MarceloCampos/PROTON2-.NetMF-Board/README.md

# PROTON2 .Net MicroFramework Board
 PROTON2 STM32F401 .NetMF Board
 
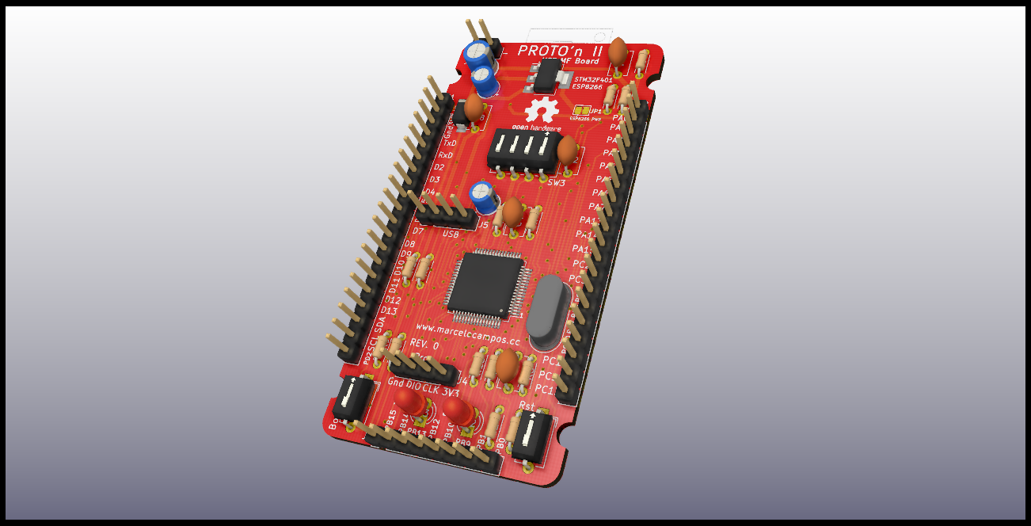
[picture p1: PROTON2_3D.png]
placa
