MarceloCampos/PROTON2-.NetMF-Board/Lista Materiais-BoardNETMF1.xlsx

 |  | PROTO’N II – Lista de Materiais |  | LOTE
 |  | Rev.0 – Mar/20 |  | 5
Qtd PCI | Qtd Lote | Descrição | Valor
5 | 25 | Capacitor Metal Film mini (amarelo) | 100 nF
1 | 5 | Cap. Eletrol. Mini x 16V | 4.7uF
1 | 5 | Cap. Eletrol. Mini x 16V | 100 uF
1 | 5 | Cap. Eletrol. Mini x 16V | 10 uF
1 | 5 | LM1117MPX_3.3 encapsulamento SOT-223
1 | 5 | Diodo SMD M7 encapsulamento DO-214AC/SMA | 1N4007 SMD
1 | 5 | Led 3mm leitoso | Vermelho
1 | 5 | Led 3mm leitoso | Verde
1 | 5 | Resistor CR12 1/8W – 5% | 680r
1 | 5 | Resistor CR12 1/8W – 5% | 1 K
3 | 15 | Resistor CR12 1/8W – 5% | 33 R
9 | 45 | Resistor CR12 1/8W – 5% | 10 K
2 | 10 | Micro chave | SW_Push
1 | 5 | Dip Switch 4 posições horizontal | SW_DIP_x04
1 | 5 | Cristal HC-49 | 8 MHz
1 | 5 | STM32F401RET6
