MarceloCampos/PROTON2-.NetMF-Board/PROTON2_sch.pdf

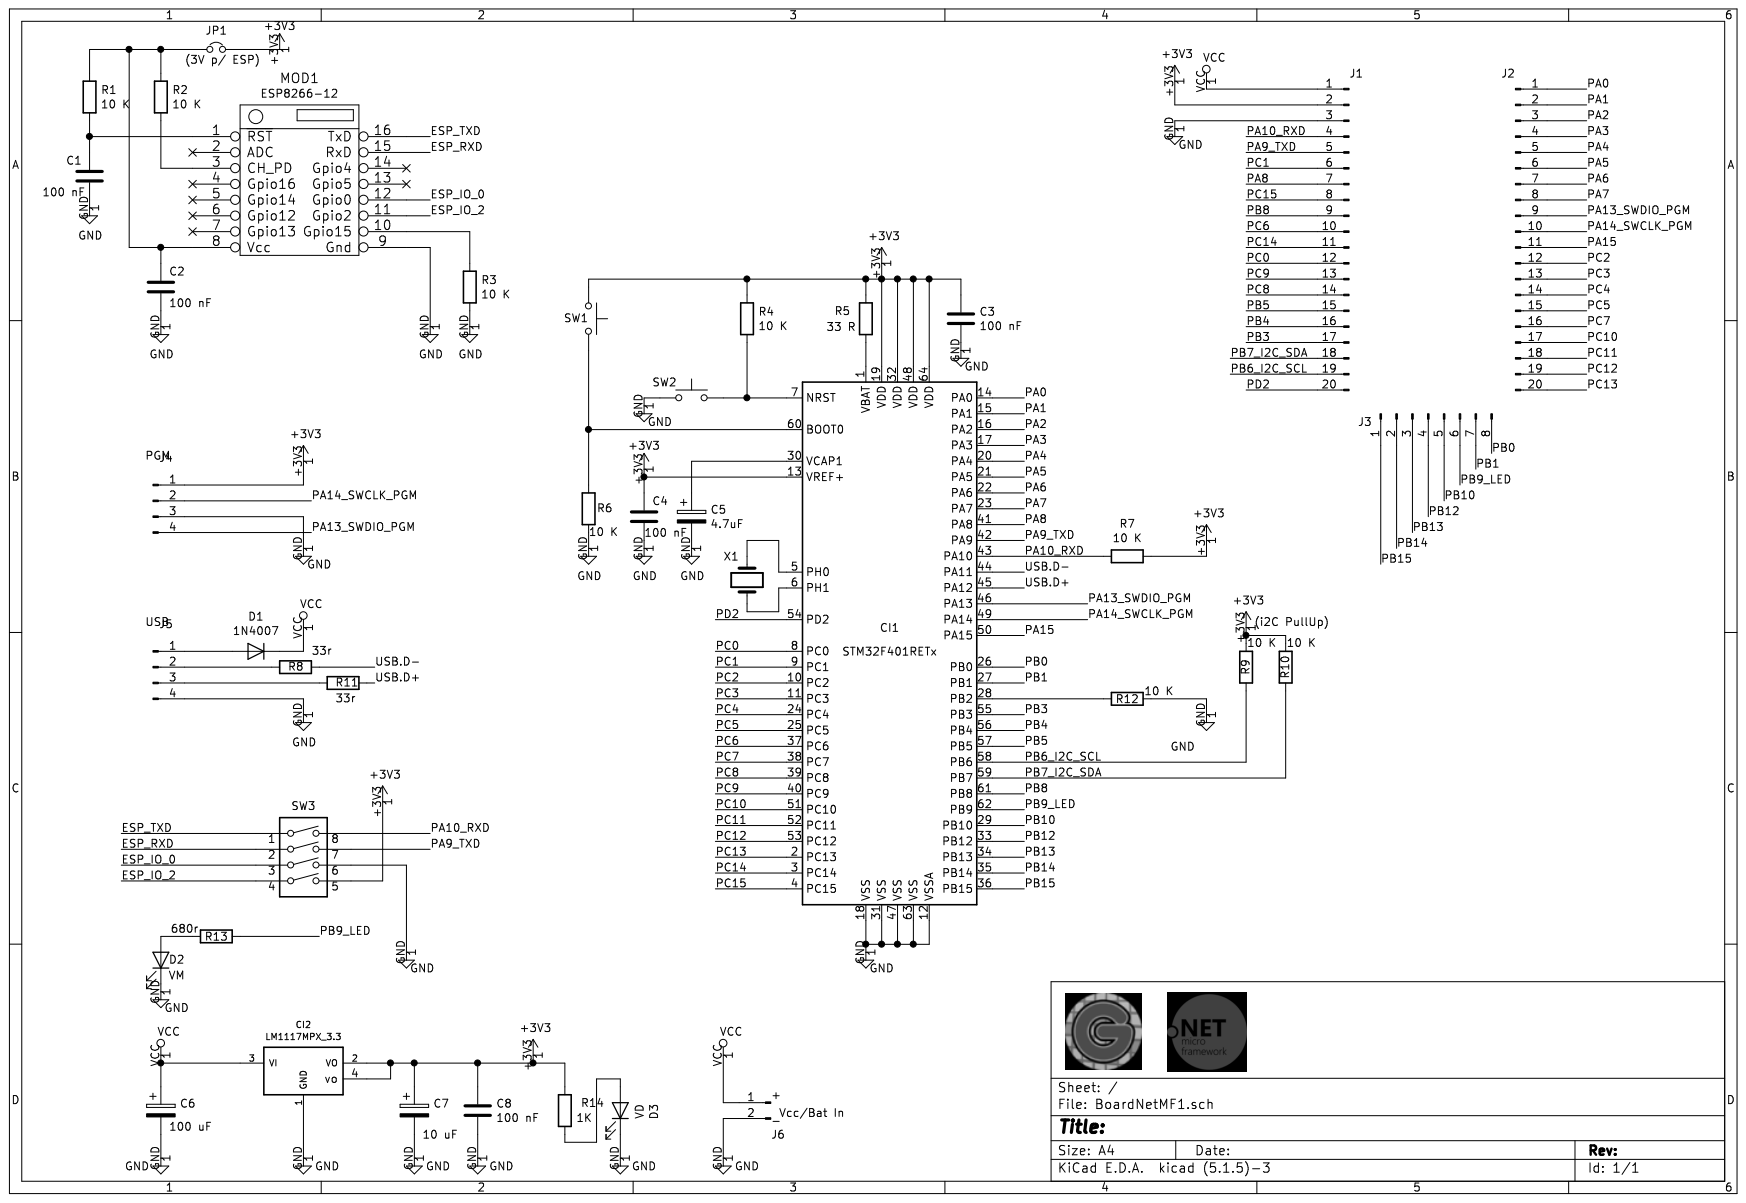
[picture p11: page 1]
