MarceloCampos/PROTON2-.NetMF-Board/BoardNetMF1.kicad_pcb

## KiCad design BoardNetMF1.kicad_pcb (2020-03-26)

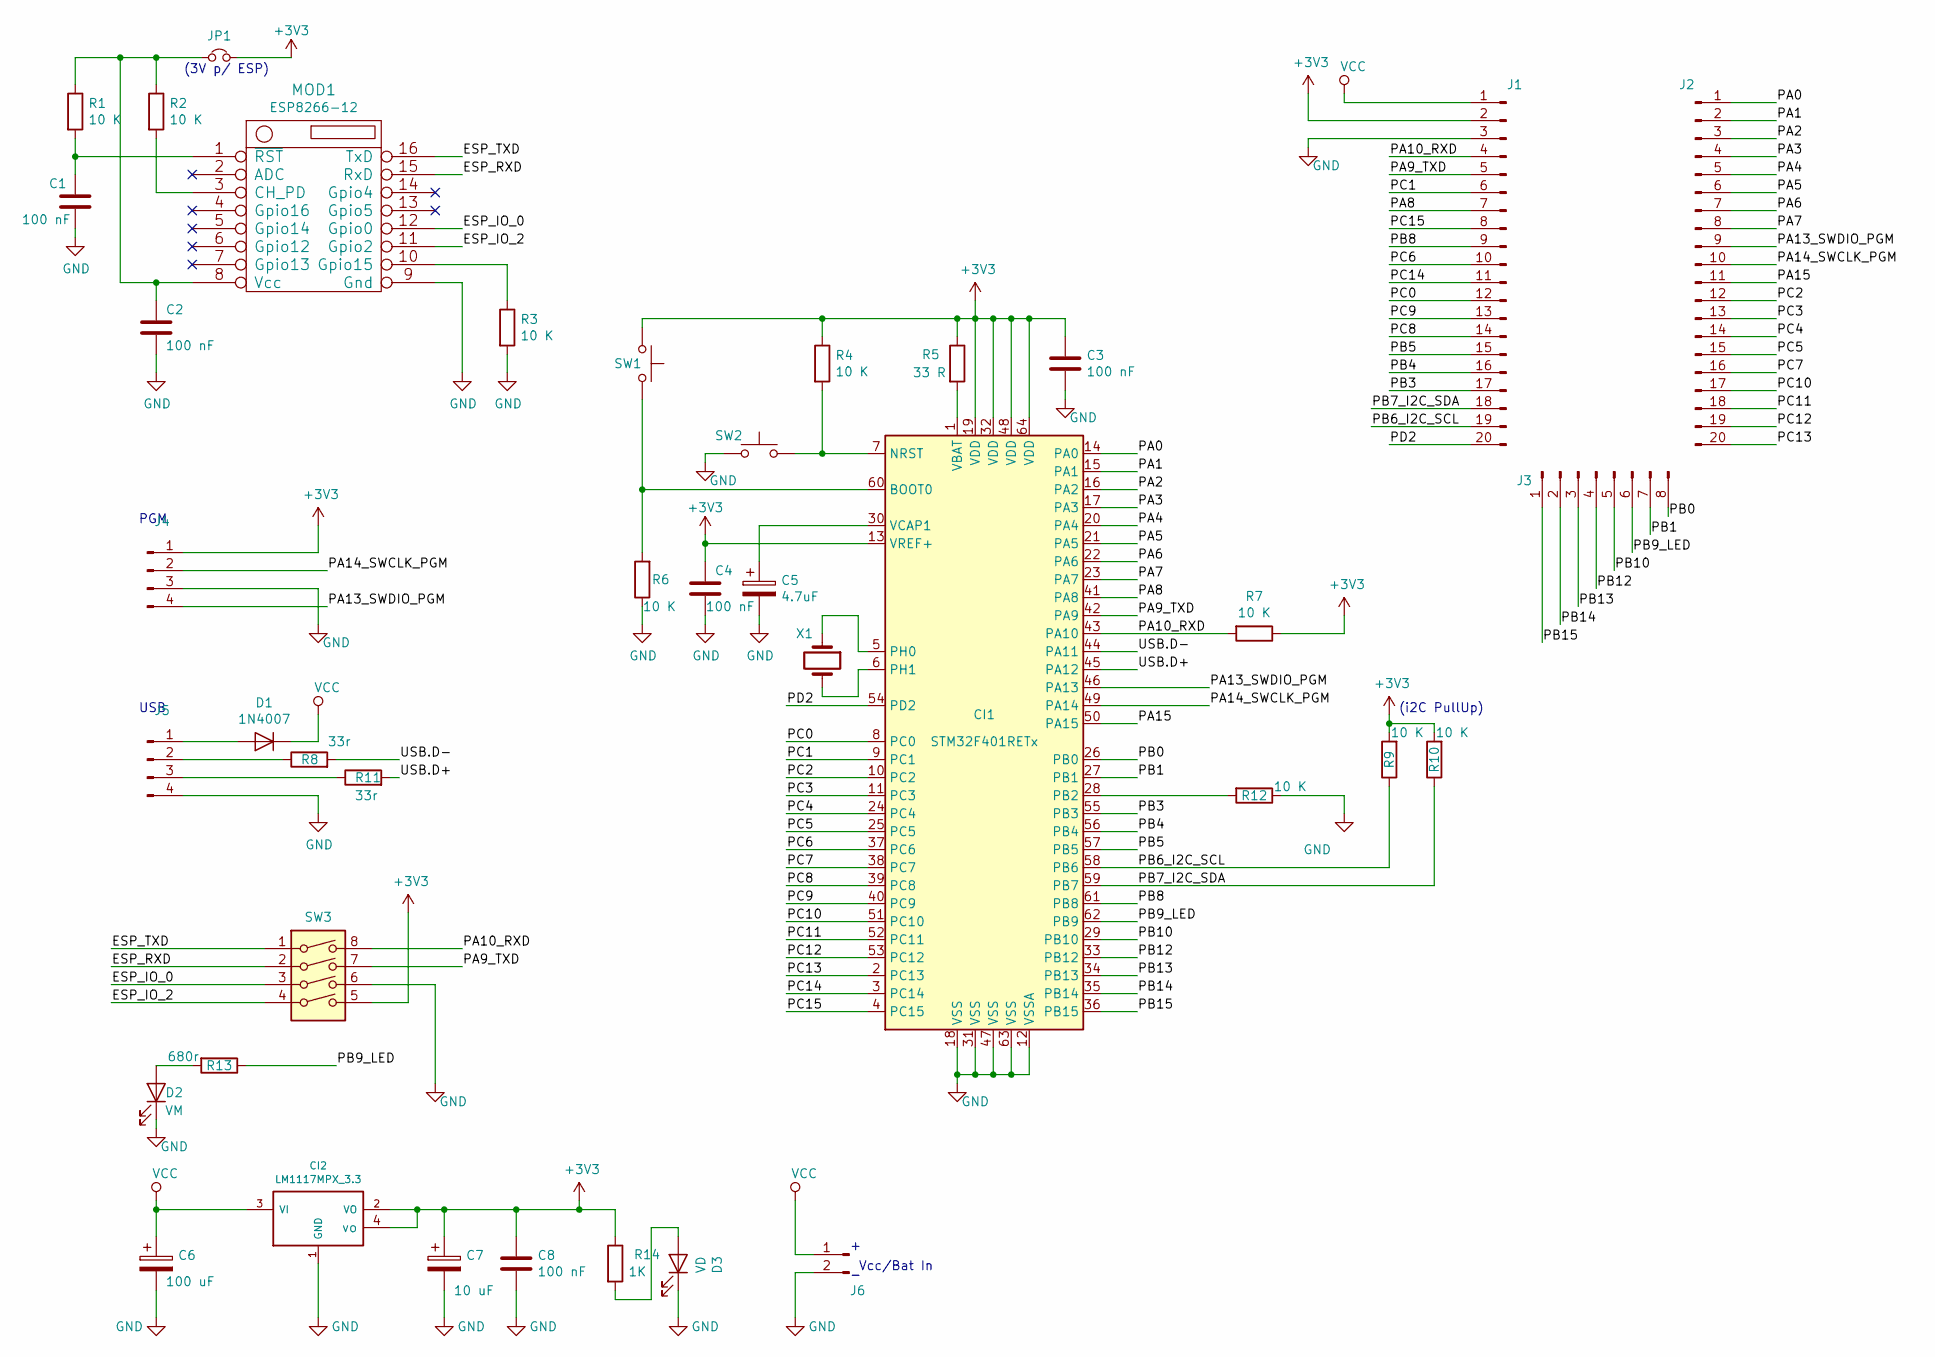
[picture p12: schematic BoardNetMF1.sch]

Parts:
C1, C2, C3, C4, C8: 100 nF; C_Disc_D5.1mm_W3.2mm_P5.00mm
C5: 4.7uF; CP_Radial_D4.0mm_P1.50mm
C6: 100 uF; CP_Radial_D5.0mm_P2.00mm
C7: 10 uF; CP_Radial_D4.0mm_P1.50mm
CI1: STM32F401RETx; LQFP-64_10x10mm_P0.5mm
CI2: LM1117MPX_3.3; SOT-223
D1: 1N4007; D_SMA
D2: VM; LED_D3.0mm
D3: VD; LED_D3.0mm
J1, J2: Conn_01x20_Male; PinHeader_1x20_P2.54mm_Vertical_RetangularPads
J3: Conn_01x08_Male; PinHeader_1x08_P2.54mm_Vertical
J4, J5: Conn_01x04_Male; PinHeader_1x04_P2.54mm_Vertical
J6: Conn_01x02_Male; PinHeader_1x02_P2.54mm_Vertical
JP1: Jumper_NC_Small; SolderJumper-2_P1.3mm_Bridged_Pad1.0x1.5mm
MOD1: ESP8266-12; ESP8266
R1, R2, R3, R4, R6, R7, R9, R10, R12: 10 K; R_Axial_DIN0204_L3.6mm_D1.6mm_P5.08mm_Horizontal
R5: 33 R; R_Axial_DIN0204_L3.6mm_D1.6mm_P5.08mm_Horizontal
R8, R11: 33r; R_Axial_DIN0204_L3.6mm_D1.6mm_P5.08mm_Horizontal
R13: 680r; R_Axial_DIN0204_L3.6mm_D1.6mm_P5.08mm_Horizontal
R14: 1K; R_Axial_DIN0204_L3.6mm_D1.6mm_P5.08mm_Horizontal
SW1, SW2: SW_Push; SW_DIP_SPSTx01_Slide_6.7x4.1mm_W7.62mm_P2.54mm_LowProfile
SW3: SW_DIP_x04; SW_DIP_SPSTx04_Slide_6.7x11.72mm_W7.62mm_P2.54mm_LowProfile
X1: 8 MHz; Crystal_HC49-4H_Vertical

Connections:
+3V3: C3.1, C4.1, C7.1, C8.1, CI1.13 (VREF+), CI1.19 (VDD), CI1.32 (VDD), CI1.48 (VDD), CI1.64 (VDD), CI2.2 (VO), CI2.4 (vo), J1.2, J4.1, JP1.2, R4.1, R5.1, R7.1, R9.2, R10.2, R14.1, SW1.2, SW3.5
/ESP_IO_0: MOD1.12 (Gpio0), SW3.3; also elsewhere on the board
/ESP_IO_2: MOD1.11 (Gpio2), SW3.4; also elsewhere on the board
/ESP_RXD: MOD1.15 (RxD), SW3.2; also elsewhere on the board
/ESP_TXD: MOD1.16 (TxD), SW3.1; also elsewhere on the board
/PA0: CI1.14 (PA0), J2.1
/PA1: CI1.15 (PA1), J2.2
/PA2: CI1.16 (PA2), J2.3
/PA3: CI1.17 (PA3), J2.4
/PA4: CI1.20 (PA4), J2.5
/PA5: CI1.21 (PA5), J2.6
/PA6: CI1.22 (PA6), J2.7
/PA7: CI1.23 (PA7), J2.8
/PA8: CI1.41 (PA8), J1.7
/PA9_TXD: CI1.42 (PA9), J1.5, SW3.7
/PA10_RXD: CI1.43 (PA10), J1.4, R7.2, SW3.8
/PA13_SWDIO_PGM: CI1.46 (PA13), J2.9, J4.4
/PA14_SWCLK_PGM: CI1.49 (PA14), J2.10, J4.2
/PA15: CI1.50 (PA15), J2.11
/PB0: CI1.26 (PB0), J3.8
/PB1: CI1.27 (PB1), J3.7
/PB3: CI1.55 (PB3), J1.17
/PB4: CI1.56 (PB4), J1.16
/PB5: CI1.57 (PB5), J1.15
/PB6_I2C_SCL: CI1.58 (PB6), J1.19, R9.1
/PB7_I2C_SDA: CI1.59 (PB7), J1.18, R10.1
/PB8: CI1.61 (PB8), J1.9
/PB9_LED: CI1.62 (PB9), J3.6, R13.1
/PB10: CI1.29 (PB10), J3.5
/PB12: CI1.33 (PB12), J3.4
/PB13: CI1.34 (PB13), J3.3
/PB14: CI1.35 (PB14), J3.2
/PB15: CI1.36 (PB15), J3.1
/PC0: CI1.8 (PC0), J1.12
/PC1: CI1.9 (PC1), J1.6
/PC2: CI1.10 (PC2), J2.12
/PC3: CI1.11 (PC3), J2.13
/PC4: CI1.24 (PC4), J2.14
/PC5: CI1.25 (PC5), J2.15
/PC6: CI1.37 (PC6), J1.10
/PC7: CI1.38 (PC7), J2.16
/PC8: CI1.39 (PC8), J1.14
/PC9: CI1.40 (PC9), J1.13
/PC10: CI1.51 (PC10), J2.17
/PC11: CI1.52 (PC11), J2.18
/PC12: CI1.53 (PC12), J2.19
/PC13: CI1.2 (PC13), J2.20
/PC14: CI1.3 (PC14), J1.11
/PC15: CI1.4 (PC15), J1.8
/PD2: CI1.54 (PD2), J1.20
/USB.D+: CI1.45 (PA12), R11.2
/USB.D-: CI1.44 (PA11), R8.2
GND: C1.2, C2.2, C3.2, C4.2, C5.2, C6.2, C7.2, C8.2, CI1.12 (VSSA), CI1.18 (VSS), CI1.31 (VSS), CI1.47 (VSS), CI1.63 (VSS), CI2.1 (GND), D2.1 (K), D3.1 (K), J1.3, J4.3, J5.4, J6.2, MOD1.9 (Gnd), R3.2, R6.1, R12.1, SW2.2, SW3.6; also elsewhere on the board
unnamed 53: C1.1, MOD1.1 (~RST), R1.2; also elsewhere on the board
unnamed 54: C2.1, JP1.1, MOD1.8 (Vcc), R1.1, R2.1; also elsewhere on the board
unnamed: C5.1, CI1.30 (VCAP1)
unnamed: CI1.1 (VBAT), R5.2
unnamed: CI1.5 (PH0), X1.1
unnamed: CI1.6 (PH1), X1.2
unnamed: CI1.7 (NRST), R4.2, SW2.1
unnamed: CI1.28 (PB2), R12.2
unnamed: CI1.60 (BOOT0), R6.2, SW1.1
unnamed: D1.2 (A), J5.1
unnamed: D2.2 (A), R13.2
unnamed: D3.2 (A), R14.2
unnamed: J5.2, R8.1
unnamed: J5.3, R11.1
unnamed 68: MOD1.3 (CH_PD), R2.2; also elsewhere on the board
unnamed 73: MOD1.10 (Gpio15), R3.1; also elsewhere on the board
VCC: C6.1, CI2.3 (VI), D1.1 (K), J1.1, J6.1

Notes on the sheet:
USB
(i2C PullUp)
PGM
+ -
Vcc/Bat In
(3V p/ ESP)

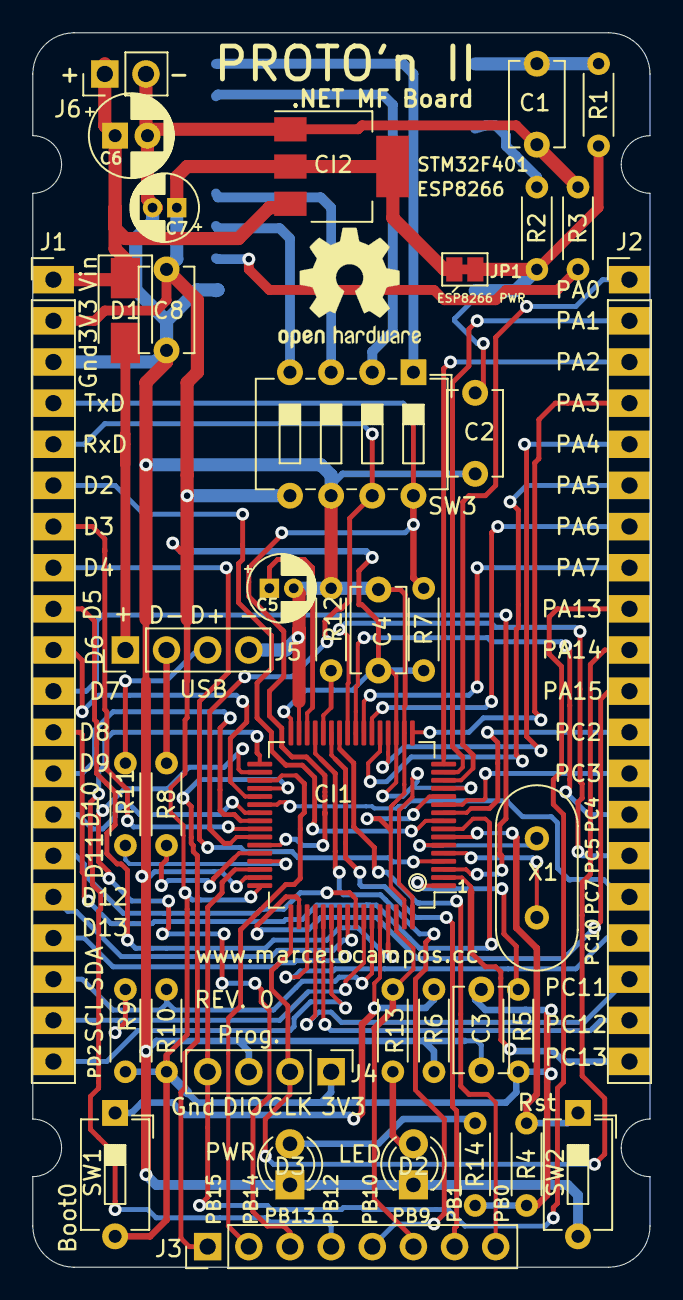
[picture p13: board BoardNetMF1.kicad_pcb from above]

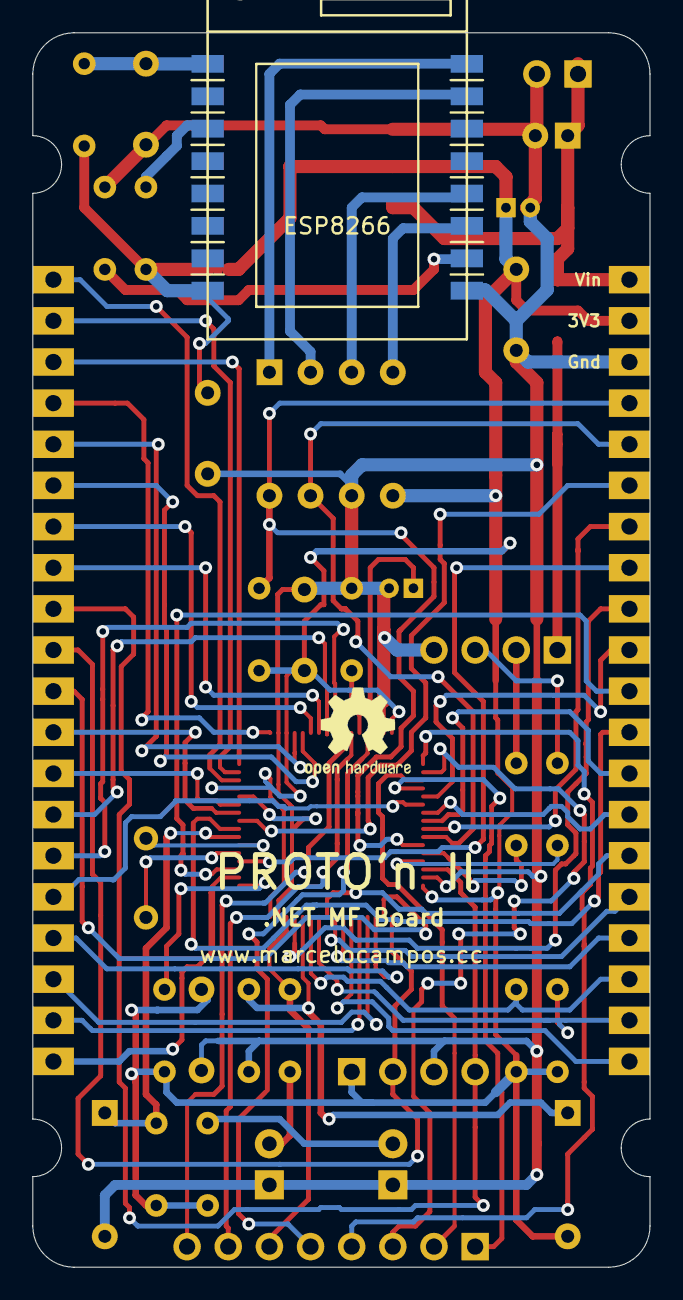
[picture p14: board BoardNetMF1.kicad_pcb from below]

Board: 2 copper layers, 38.1 x 76.2 mm, 40 parts (2 on the bottom side), 70 nets.

Other parts of the board:
 : OSHW-Logo2_7.3x6mm_SilkScreen
ESP8266: ESP8266-12; ESP8266

Their connections:
/ESP_IO_0: ESP8266.12; also elsewhere on the board
/ESP_IO_2: ESP8266.11; also elsewhere on the board
/ESP_RXD: ESP8266.15; also elsewhere on the board
/ESP_TXD: ESP8266.16; also elsewhere on the board
GND: ESP8266.9; also elsewhere on the board
unnamed 53: ESP8266.1; also elsewhere on the board
unnamed 54: ESP8266.8; also elsewhere on the board
unnamed 68: ESP8266.3; also elsewhere on the board
unnamed 73: ESP8266.10; also elsewhere on the board
