MarceloCampos/PROTON2-.NetMF-Board/(commit log)

2020-03-26 first commit
    upload
    [BoardNetMF1-B_Cu.gbr, BoardNetMF1-B_Mask.gbr, BoardNetMF1-B_SilkS.gbr, BoardNetMF1-Edge_Cuts.gbr, BoardNetMF1-F_Cu.gbr, BoardNetMF1-F_Mask.gbr, BoardNetMF1-F_SilkS.gbr, BoardNetMF1-NPTH.drl]
2020-07-15 Add files via upload
    Adicionar 'TinyCLR OS Project System v1.0.0.vsix' no VS2017 em Ferramentas-> Extensões e Atualizações
    Nota: desabilitar atualizar automática dessa extensão para que ela não 'quebre' atualizando pra v2.0
